egueli/FD-8/hardware/FD-8 Hall Support.FCStd

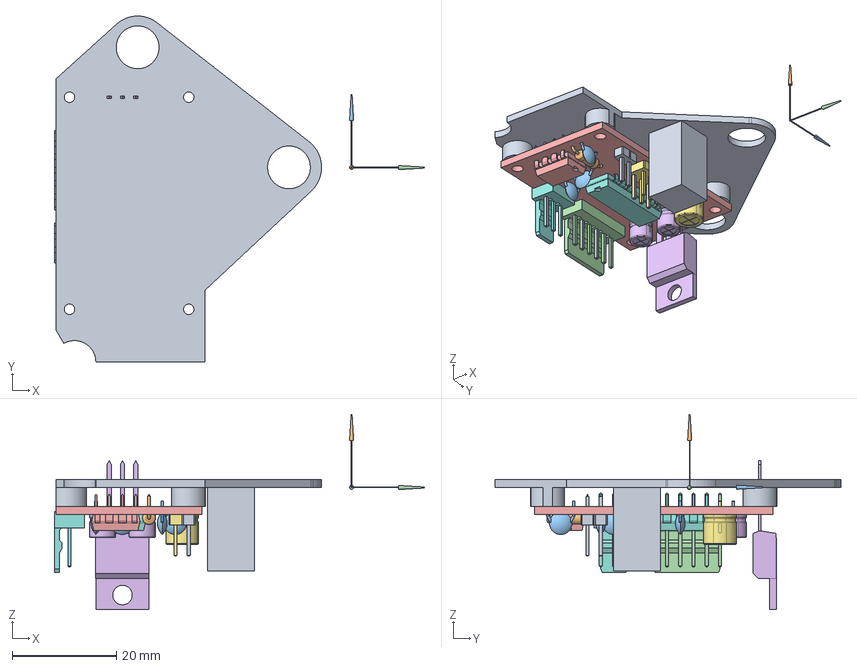
[picture p1: CAD file, 2025-05-09]
hardware/FD-8 Hall Support.FCStd
71.0 x 66.3 x 37.4 mm
Support
Z
Y
X
Pcb_9545
C1_CP_Radial_D50mm_P250mm_7942a5c43449 x 2
C3_CP_Radial_D63mm_P250mm_a3e9f446e89b
U3_DIP-14_W7.62mm_5a3bde0884b8
J4_PinHeader_1x02_P254mm_Vertical_ea4d6b2bdc14
R1_R_Axial_DIN0207_L63mm_D25mm_P1016mm_Horizontal_d808c587b3e5
C6_C_Disc_D43mm_W19mm_P500mm_b1710f0608f5 x 4
J1_Molex_AE_6410_06A_8faf24b0fe37
U2_DIP-8_W7.62mm_321997fab1cf
U1_TO-220-3_Vertical_4130ba1ba9db
J2_PinHeader_2x03_P254mm_Vertical_67d37e8a4aec
J3_Molex_AE_6410_03A_737c8d059b74
