egueli/FD-8/hardware/Support.3mf

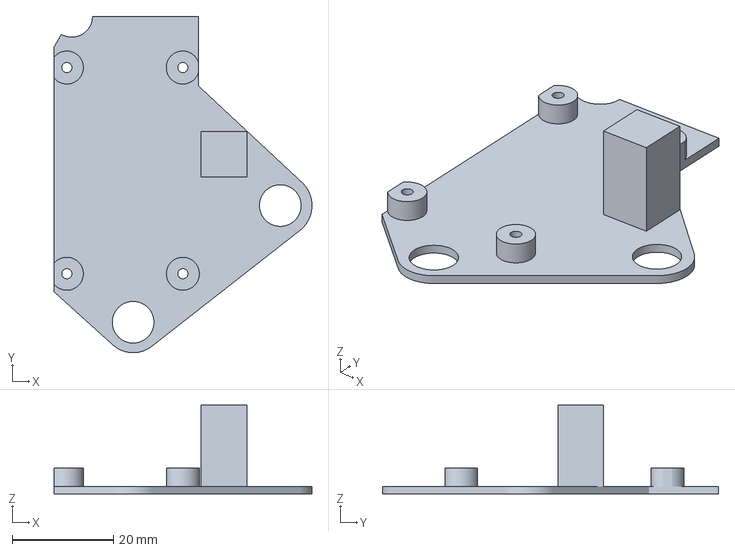
[picture p2: CAD file, 2025-05-09]
hardware/Support.3mf
50.8 x 66.3 x 17.5 mm
