egueli/FD-8/hardware/SupportPCB.dxf

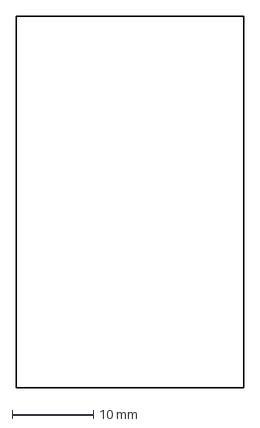
[picture p3: CAD file, 2025-05-06]
hardware/SupportPCB.dxf
27.9 x 45.7 mm
