egueli/FD-8/(list of files, cad)

Other CAD files:
hardware/Support.stl
