egueli/FD-8/hardware/FD-8 Hall Sensor/FD-8 Hall Sensor.kicad_pcb

## KiCad design hardware/FD-8 Hall Sensor/FD-8 Hall Sensor.kicad_pcb (2025-05-06)

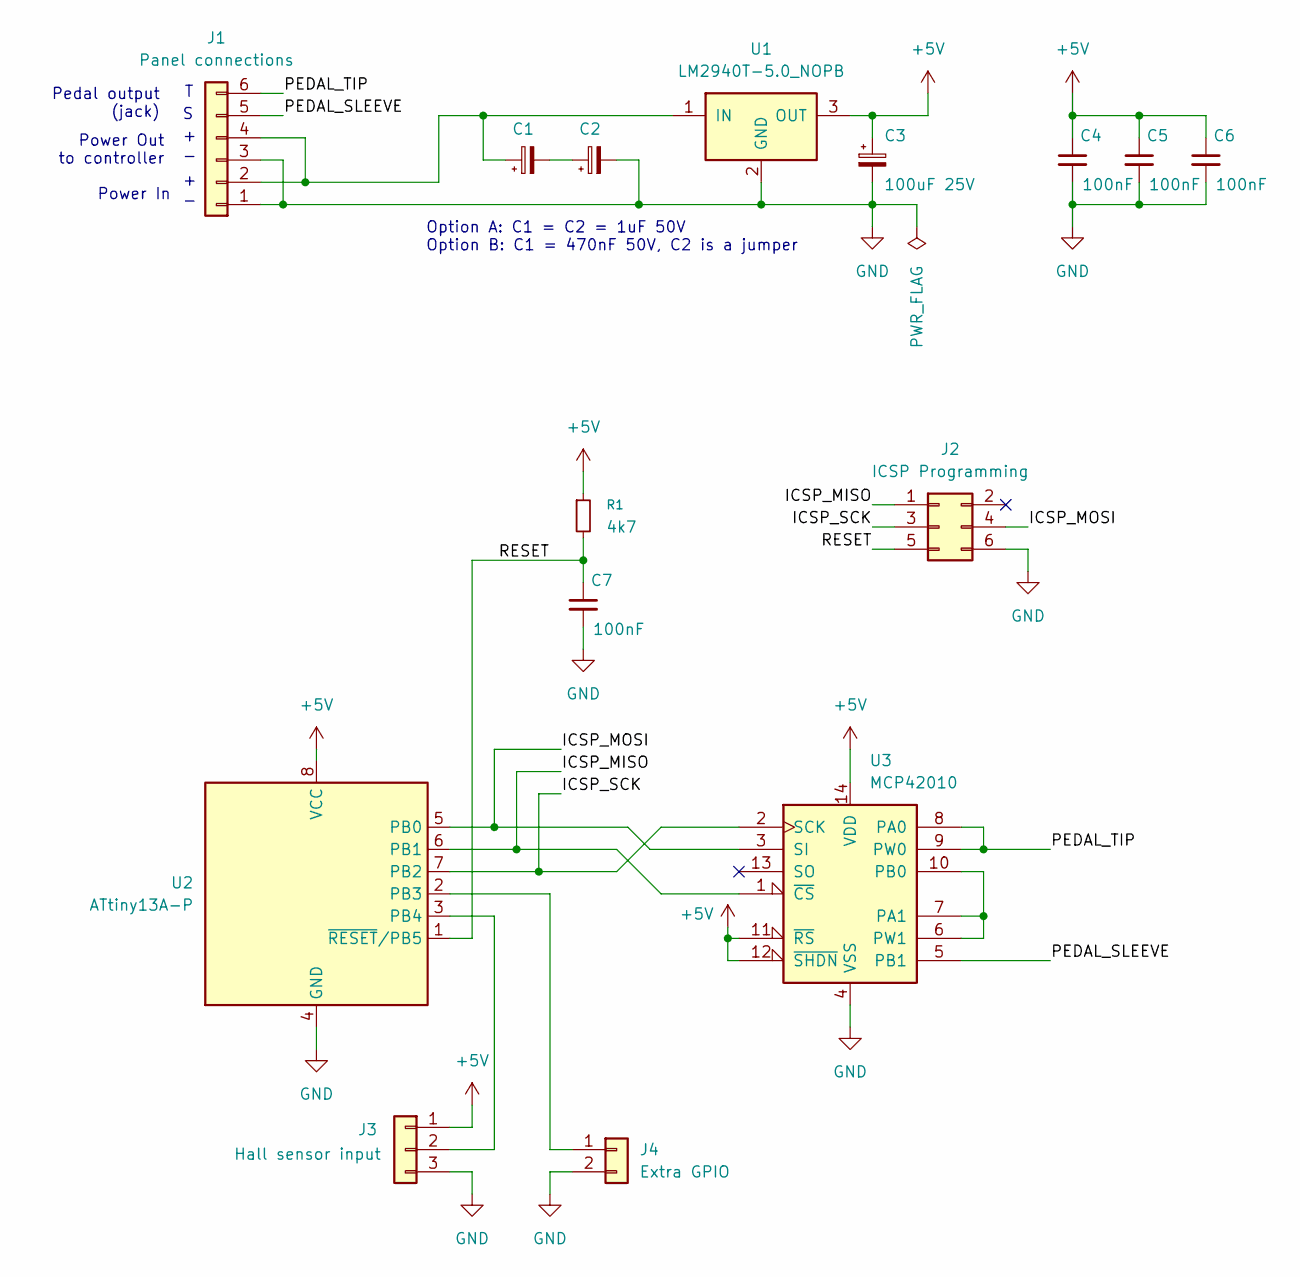
[picture p4: schematic FD-8 Hall Sensor.kicad_sch]

Parts:
C1, C2: CP_Radial_D5.0mm_P2.50mm
C3: 100uF 25V; CP_Radial_D6.3mm_P2.50mm
C4, C5, C6, C7: 100nF; C_Disc_D4.3mm_W1.9mm_P5.00mm
J1: Panel connections; Molex_KK-254_AE-6410-06A_1x06_P2.54mm_Vertical
J2: ICSP Programming; PinHeader_2x03_P2.54mm_Vertical
J3: Hall sensor input; Molex_KK-254_AE-6410-03A_1x03_P2.54mm_Vertical
J4: Extra GPIO; PinHeader_1x02_P2.54mm_Vertical
R1: 4k7; R_Axial_DIN0207_L6.3mm_D2.5mm_P10.16mm_Horizontal
U1: LM2940T-5.0_NOPB; TO-220-3_Vertical
U2: ATtiny13A-P; DIP-8_W7.62mm
U3: MCP42010; DIP-14_W7.62mm

Connections:
+5V: C3.1, C4.1, C5.1, C6.1, J3.1, R1.1, U1.3 (OUT), U2.8 (VCC), U3.11 (~RS), U3.12 (~SHDN), U3.14 (VDD)
/ICSP_MISO: J2.1, U2.6 (PB1), U3.1 (~CS)
/ICSP_MOSI: J2.4, U2.5 (PB0), U3.3 (SI)
/ICSP_SCK: J2.3, U2.7 (PB2), U3.2 (SCK)
/PEDAL_SLEEVE: J1.5, U3.5 (PB1)
/PEDAL_TIP: J1.6, U3.8 (PA0), U3.9 (PW0)
/RESET: C7.1, J2.5, R1.2, U2.1 (~RESET/PB5)
GND: C2.2, C3.2, C4.2, C5.2, C6.2, C7.2, J1.1, J1.3, J2.6, J3.3, J4.2, U1.2 (GND), U2.4 (GND), U3.4 (VSS)
unnamed: C1.2, C2.1
unnamed: C1.1, J1.2, J1.4, U1.1 (IN)
unnamed: J3.2, U2.3 (PB4)
unnamed: J4.1, U2.2 (PB3)
unnamed: U3.6 (PW1), U3.7 (PA1), U3.10 (PB0)

Notes on the sheet:
Power In
Option A: C1 = C2 = 1uF 50V Option B: C1 = 470nF 50V, C2 is a jumper
Power Out to controller
Pedal output (jack)

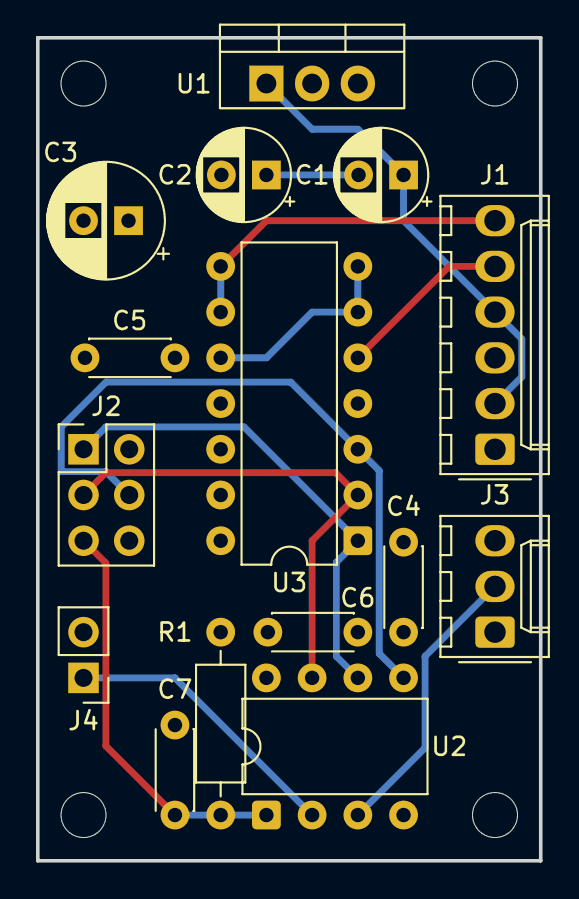
[picture p5: board FD-8 Hall Sensor.kicad_pcb from above]

Board: 4 copper layers, 27.9 x 45.7 mm, 15 parts (0 on the bottom side), 13 nets.
