egueli/FD-8/test/test_mapper/test_mapper.cpp

#include <unity.h>
#include "adc.h"
#include "mapper.h"
#include <iostream>

// Some ADC values sampled from real sensing (Allegro A1302)
const uint16_t kAdcRest = 508;
const uint16_t kAdcFullPushDelta = 45;
const uint16_t kAdcFullPushNorth = kAdcRest - kAdcFullPushDelta;
const uint16_t kAdcFullPushSouth = kAdcRest + kAdcFullPushDelta;
const uint16_t kAdcHalfPushNorth = kAdcRest - (kAdcFullPushDelta / 2);

void setUp(void) {
}

void tearDown(void) {
    // clean stuff up here
}

void testFullPush(uint16_t pushValue) {
    adc adc;
    PedalMapper<> mapper;

    // start at some rest value to perform initial calibration
    adc.test_set(kAdcRest);
    mapper.init_pedal_calibration(adc);

    // simulate a full push down to do self-calibration
    adc.test_set(pushValue);
    mapper.read_scaled_pedal(adc);
    // the mapper is now calibrated and ready for business.

    // At rest, the pot value should be near 255. Actually it gets quite a bit
    // far from that due to unknown effects (or just undiscovered mapping bugs).
    adc.test_set(kAdcRest);

    TEST_ASSERT_GREATER_OR_EQUAL(180, mapper.read_scaled_pedal(adc));
}

void test_pushNorth(void) {
    testFullPush(kAdcFullPushNorth);
}

void test_pushSouth(void) {
    testFullPush(kAdcFullPushSouth);
}

/**
 * @brief Verifies that the calibration can change at least twice.
 */
void test_calibrationChange(void) {
    // GIVEN we have an ADC and a mapper calibrated on a half-push
    adc adc;
    PedalMapper<> mapper;
    adc.test_set(kAdcRest);
    mapper.init_pedal_calibration(adc);
    adc.test_set(kAdcHalfPushNorth);
    mapper.read_scaled_pedal(adc);
    auto half_scaled = mapper.read_scaled_pedal(adc);

    // WHEN the foot is fully pressed, then half-pressed again
    adc.test_set(kAdcFullPushNorth);
    mapper.read_scaled_pedal(adc);
    adc.test_set(kAdcHalfPushNorth);

    // THEN the mapper recalibrates and returns a different value
    // than before the full press.
    auto full_scaled = mapper.read_scaled_pedal(adc);

    TEST_ASSERT_NOT_EQUAL(half_scaled, full_scaled);
}

/**
 * @brief Verifies that when the mapper locked, no recalibration occurs.
 */
void test_noCalibrationChangeWhenLocked(void) {
    // GIVEN we have an ADC and a mapper calibrated on a half-push
    adc adc;
    PedalMapper<> mapper;
    adc.test_set(kAdcRest);
    mapper.init_pedal_calibration(adc);
    adc.test_set(kAdcHalfPushNorth);
    mapper.read_scaled_pedal(adc);
    auto half_scaled = mapper.read_scaled_pedal(adc);

    // WHEN the mapper is locked
    mapper.lock();

    // AND the foot is fully pressed, then half-pressed again
    adc.test_set(kAdcFullPushNorth);
    mapper.read_scaled_pedal(adc);
    adc.test_set(kAdcHalfPushNorth);

    // THEN the mapper does not recalibrat, and returns the same value
    // as before the full press.
    auto full_scaled = mapper.read_scaled_pedal(adc);

    TEST_ASSERT_EQUAL(half_scaled, full_scaled);
}


void dumpMappingTable(uint16_t pushValue) {
    adc adc;
    PedalMapper<> mapper;

    adc.test_set(kAdcRest);
    mapper.init_pedal_calibration(adc);

    // simulate a full push down to do self-calibration
    adc.test_set(pushValue);
    mapper.read_scaled_pedal(adc);
    // the mapper is now calibrated and ready for business.

    int direction = (pushValue > kAdcRest) ? 1 : -1;
    for (int i = kAdcRest; i != pushValue; i += direction) {
        adc.test_set(i);
        std::cout << "adc=" << i << " mapped=" << +mapper.read_scaled_pedal(adc) << std::endl;
    }
    adc.test_set(kAdcRest);
}

void dump_northTable(void) {
    std::cout << "Mapping table, north direction (foot push decreases value)" << std::endl;
    dumpMappingTable(kAdcFullPushNorth);
}

void dump_southTable(void) {
    std::cout << "Mapping table, south direction (foot push increases value)" << std::endl;
    dumpMappingTable(kAdcFullPushSouth);
}

int main( int argc, char **argv) {
    UNITY_BEGIN();
    RUN_TEST(test_pushNorth);
    RUN_TEST(test_pushSouth);
    RUN_TEST(test_calibrationChange);
    RUN_TEST(test_noCalibrationChangeWhenLocked);

    // These are not real tests, but are just meant to show the mapper behavior with a
    // table-like output. Run "pio debug -v" or Advanced > Verbose Test to print those
    // tables.
    RUN_TEST(dump_northTable);
    RUN_TEST(dump_southTable);

    UNITY_END();
}
