egueli/FD-8/(commit log)

2025-03-29 fix ADC channel
2025-03-30 use class adc like a real one
2025-03-31 move adc class to own file
2025-03-31 build adc with stubs for unit testing
2025-04-06 Revert "make unit tests compilable"
    This reverts commit 0a86bf800bc8c9139bae681b4aafe802e63dcd4f.
    [fd8.cpp]
2025-04-06 non-static adc members
2025-04-06 add adc mock control
2025-04-06 test mapper calibration (failing)
    [test_mapper.cpp]
2025-04-06 add debug pin for scope triggering
2025-04-07 basic FreeCAD stuff
    [FD-8 Hall Support.FCStd]
2025-04-07 make base plate using 3 of the screw holes
    [FD-8 Hall Support.FCStd]
2025-04-07 add sensor riser
    [FD-8 Hall Support.FCStd]
2025-04-07 WIP add schematic
    [FD-8 Hall Sensor.kicad_pcb, FD-8 Hall Sensor.kicad_sch]
2025-04-09 add LM2940T, finish power section
    [FD-8 Hall Sensor.kicad_sch]
2025-04-09 add remaining components to schematic
    [FD-8 Hall Sensor.kicad_sch]
2025-05-03 add support for lock button
2025-05-04 REVERTME replace ADC and mapping w/ generator
    [fd8.cpp]
2025-05-06 fix schematic, pair footprints
    [FD-8 Hall Sensor.kicad_sch]
2025-05-06 add extra GPIO header
    [FD-8 Hall Sensor.kicad_sch]
2025-05-06 update support
    [FD-8 Hall Support.FCStd]
2025-05-06 WIP sync PCB layout
    [FD-8 Hall Support.FCStd, SupportPCB.dxf]
2025-05-06 more surface area
    [FD-8 Hall Support.FCStd]
2025-05-06 FCStd update
    [FD-8 Hall Support.FCStd]
2025-05-06 update PCB placement
    [FD-8 Hall Sensor.kicad_pcb, FD-8 Hall Sensor.kicad_sch]
2025-05-06 update PCB dxf
    [SupportPCB.dxf]
2025-05-06 WIP more design
    [Support.3mf, Support.stl]
2025-05-06 use MCP42010 (both pots) instead of MCP42100
    [FD-8 Hall Sensor.kicad_pcb, FD-8 Hall Sensor.kicad_sch]
2025-05-06 fix caps; lock mounting holes
    [FD-8 Hall Sensor.kicad_pcb, FD-8 Hall Sensor.kicad_sch]
2025-05-06 routing etc.
    [FD-8 Hall Sensor.kicad_pcb]
2025-05-06 add PCB mounting standoffs; made gerber; tweak base holes
    [FD-8 Hall Sensor.kicad_pcb, FD-8 Hall Support.FCStd]
2025-05-06 update support 3D files
    [Support.3mf, Support.stl]
2025-05-06 HW update
    [FD-8 Hall Support.FCStd]
2025-05-09 increase standoff height for my screws
    [FD-8 Hall Support.FCStd, Support.3mf, Support.stl]
2025-05-17 use device-agnostic environment names
2025-05-17 switch to ATtiny85
